cortrace/cortrace-hw/README.md

# cortrace-hw
Cortrace Hardware Design KiCad Project
