cortrace/cortrace-hw/cortrace-connector/cortrace-connector.kicad_pcb

## KiCad design cortrace-connector/cortrace-connector.kicad_pcb (2026-10-27)

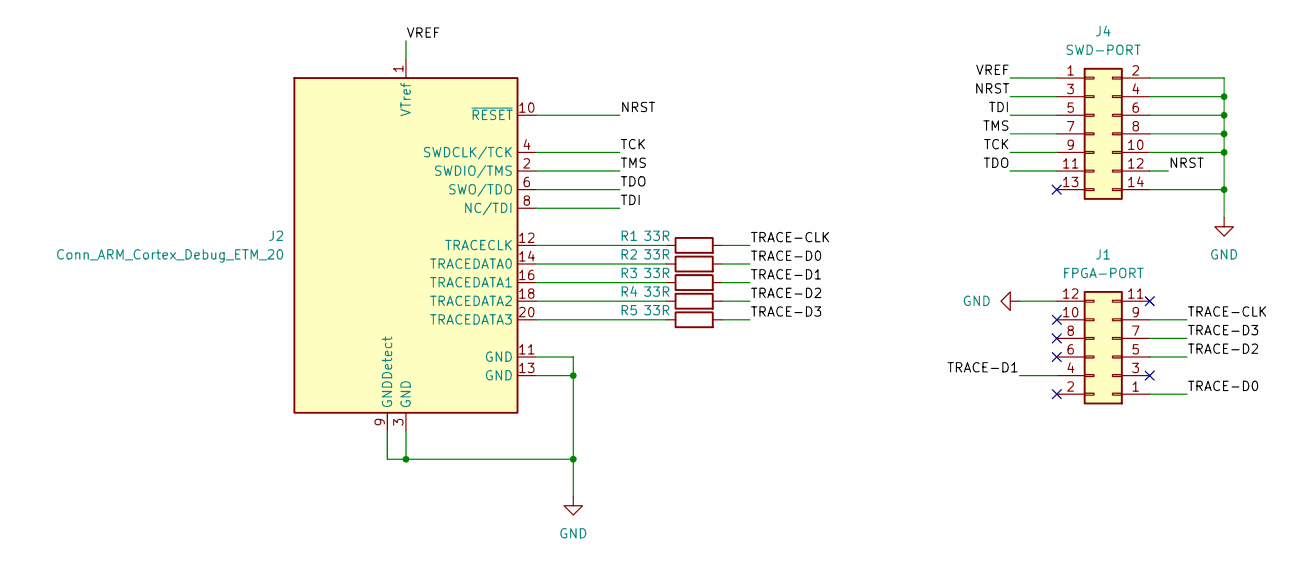
[picture p1: schematic cortrace-connector.kicad_sch, Cortrace Connector]

Parts:
J1: FPGA-PORT; PinHeader_2x06_P2.54mm_Vertical
J2: Conn_ARM_Cortex_Debug_ETM_20; PinSocket_2x10_P1.27mm_Vertical_SMD
J4: SWD-PORT; PinHeader_2x07_P2.54mm_Vertical
R1, R2, R3, R4, R5: 33R; C_0402_1005Metric

Connections:
/NRST: J2.10 (~RESET), J4.3, J4.12
/TCK: J2.4 (SWDCLK/TCK), J4.9
/TDI: J2.8 (NC/TDI), J4.5
/TDO: J2.6 (SWO/TDO), J4.11
/TMS: J2.2 (SWDIO/TMS), J4.7
/TRACE-CLK: J1.9, R1.2
/TRACE-D0: J1.1, R2.2
/TRACE-D1: J1.4, R3.2
/TRACE-D2: J1.5, R4.2
/TRACE-D3: J1.7, R5.2
/VREF: J2.1 (VTref), J4.1
GND: J1.12, J2.3 (GND), J2.5 (GND), J2.9 (GNDDetect), J2.11 (GND), J2.13 (GND), J2.15 (GND), J2.17 (GND), J2.19 (GND), J4.2, J4.4, J4.6, J4.8, J4.10, J4.14
unnamed: J2.12 (TRACECLK), R1.1
unnamed: J2.14 (TRACEDATA0), R2.1
unnamed: J2.16 (TRACEDATA1), R3.1
unnamed: J2.18 (TRACEDATA2), R4.1
unnamed: J2.20 (TRACEDATA3), R5.1

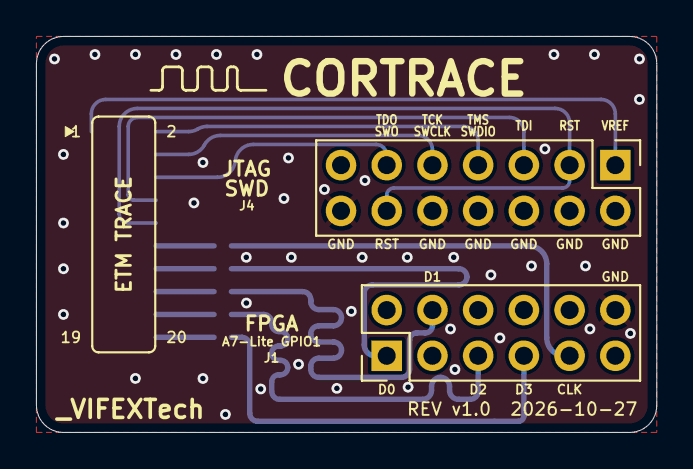
[picture p2: board cortrace-connector.kicad_pcb from above]

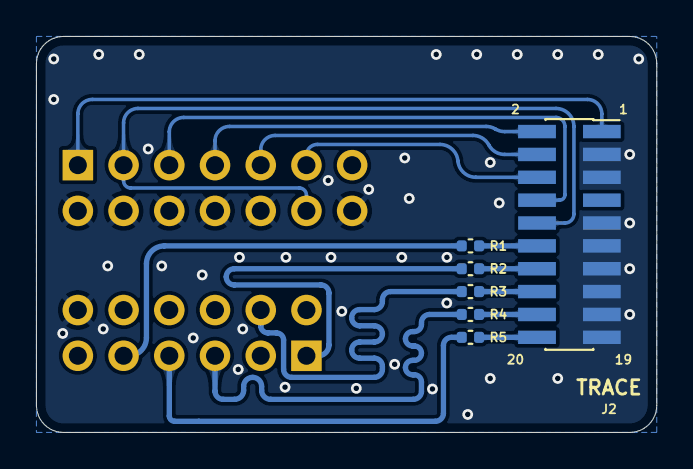
[picture p3: board cortrace-connector.kicad_pcb from below]

Board: 2 copper layers, 34.5 x 22.0 mm, 8 parts (6 on the bottom side), 17 nets.
