cortrace/cortrace-hw/(commit log)

2026-10-27 feat(connector): add the cortrace-connector KiCad project
    A Cortex Debug+ETM 20-pin connector board for the parallel trace port (TRACECLK and TRACED0..3), KiCad 9.
    [cortrace-connector.kicad_pcb, cortrace-connector.kicad_sch]
2026-10-27 feat(connector): lay out and route the adapter board
    [cortrace-connector.kicad_pcb]
2026-10-27 feat(connector): re-lay out the adapter board with arc routing
    Import the board rules from DutyCycle, follow the sketched placement (TRACE socket left, JTAG and FPGA headers right), route every signal on B.Cu with arcs and no vias, add teardrops, GND pours, stitching vias and silkscreen (logo, author, revision, date, pin names).
    [cortrace-connector.kicad_pcb]
2026-10-27 feat(connector): length-match the TRACE nets and centre the board on J2
    All five TRACE nets (J2 pad to J1 pad) are 24.174 mm. CLK now runs straight through the gap between the headers; D0..D3 are tuned with rounded bumps and a trombone, each in space only that net reaches. The outline is symmetric about the J2 centre.
    [cortrace-connector.kicad_pcb]
2026-10-27 feat(connector): label the SWD pin names on the debug header
    TMS/SWDIO, TCK/SWCLK and TDO/SWO share a pin each, so the silkscreen shows both names on two lines. VREF and RST apply to both modes.
    [cortrace-connector.kicad_pcb]
2026-10-27 feat(connector): widen TRACE spacing and pour GND between the lines
    Differently-named TRACE nets now keep at least a 0.92 mm edge gap wherever they run side by side (was 0.3 mm in places), so a 0.6 mm GND strip is poured between them and tied to the top plane with shield vias. Lengths stay matched at 27.110 mm. Board is 34.5 x 22.0 mm.
    [cortrace-connector.kicad_pcb]
2026-10-27 feat(connector): use a 1.27 mm SMD female socket for the TRACE port
    Swap J2 from the pin header footprint to the stock KiCad PinSocket_2x10_P1.27mm_Vertical_SMD. Its pads are already numbered mirrored, so the back-side placement needs no pad swap and the footprint matches the library again.
    [cortrace-connector.kicad_pcb, cortrace-connector.kicad_sch]
